sn4k3/FanController/README.md

# FanController
 PWM fan controller using ATtiny85

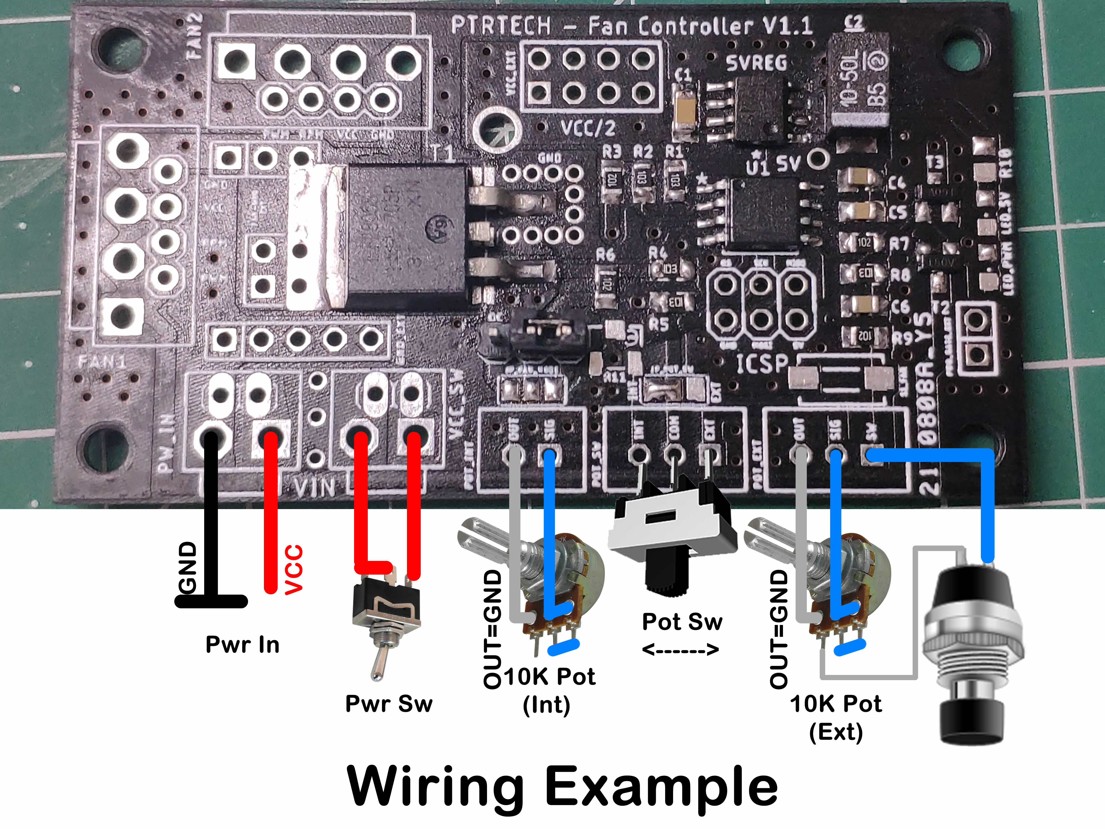
[picture p1: v1.1/img/Wiring.jpg]
Wiring example
