sn4k3/FanController/pictures/IMG_20190715_170745_1.jpg

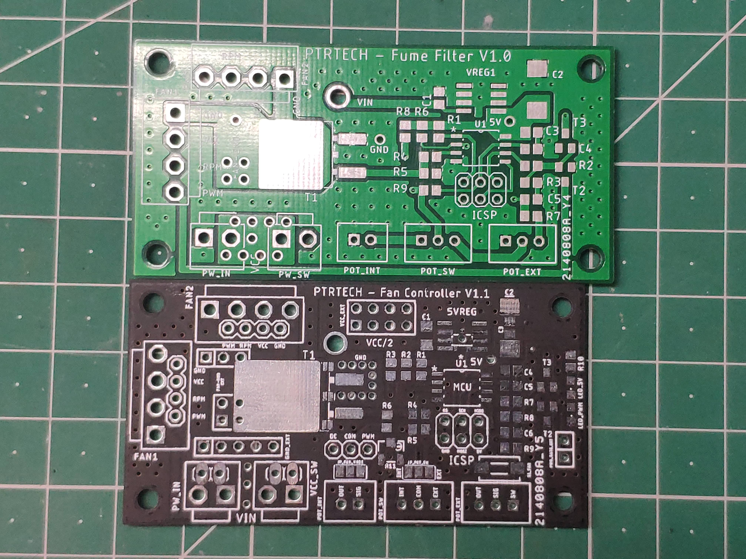
pictures/IMG_20190715_170745_1.jpg
