sn4k3/FanController/pictures/IMG_20190715_171322.jpg

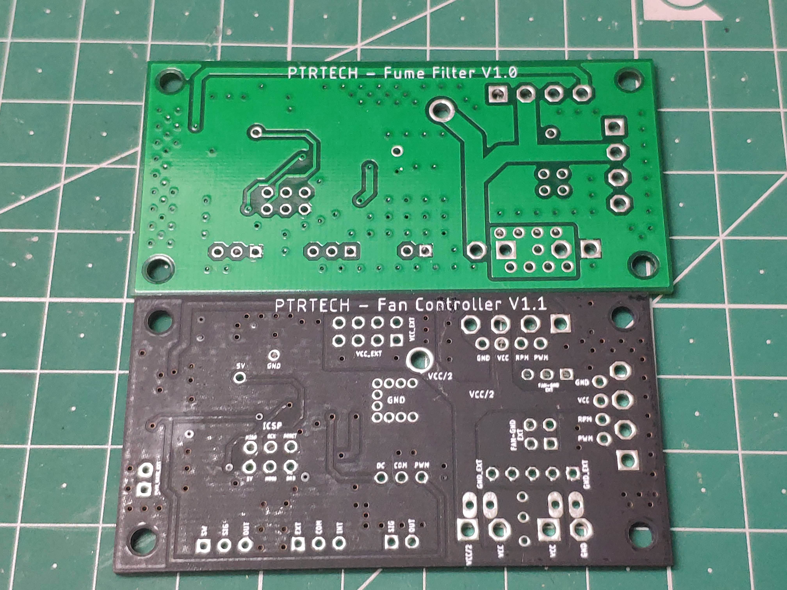
pictures/IMG_20190715_171322.jpg
