sn4k3/FanController/pictures/IMG_20190715_215148.jpg

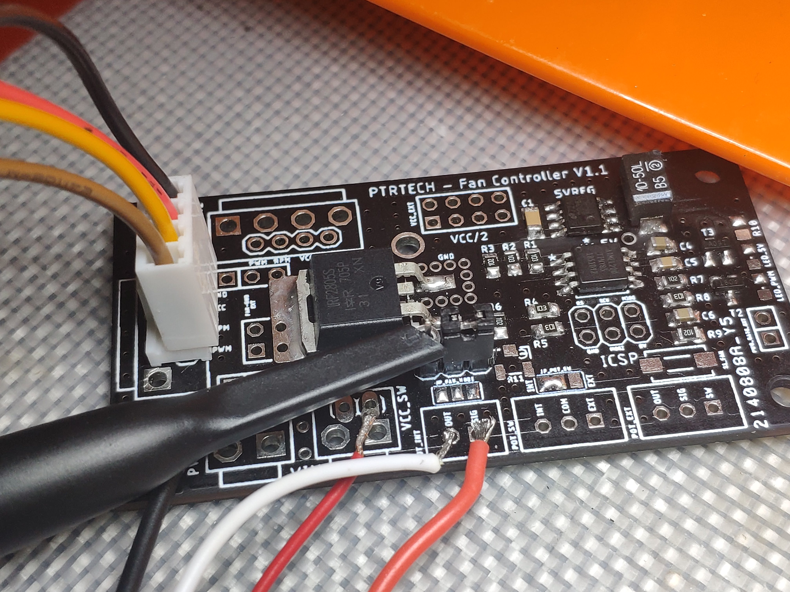
pictures/IMG_20190715_215148.jpg
