sn4k3/FanController/pictures/IMG_20190720_185601.jpg

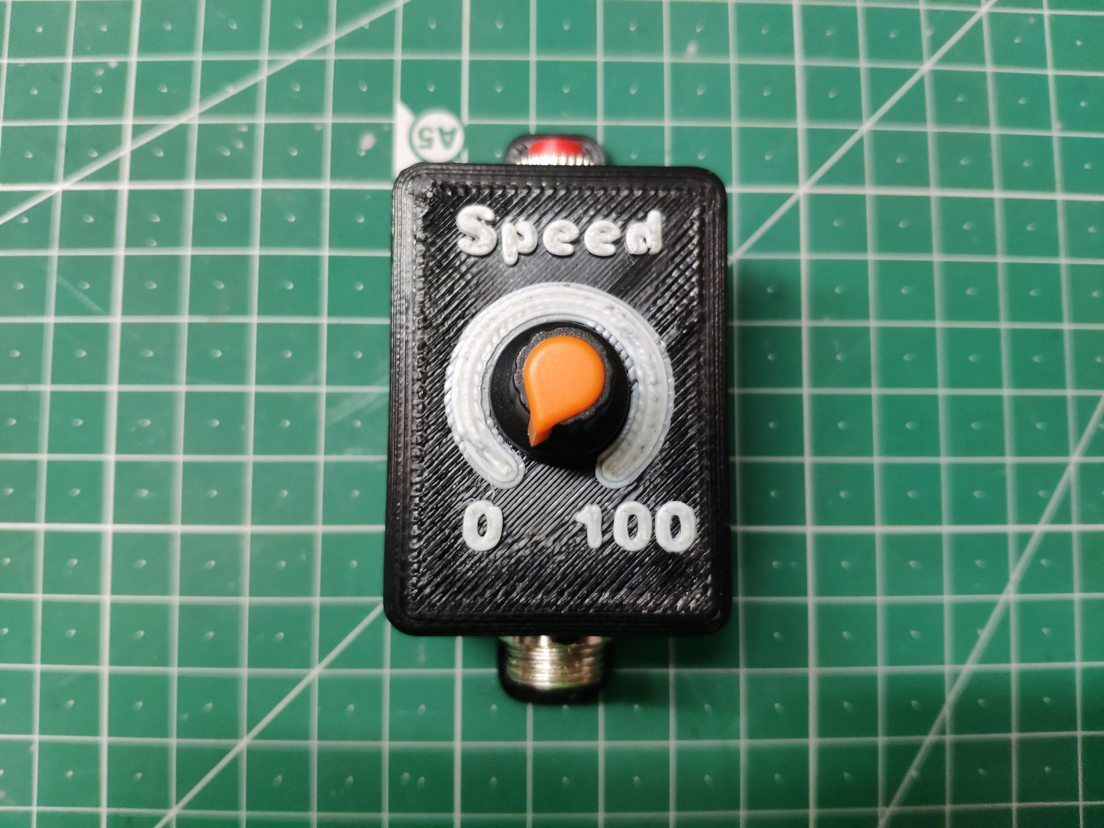
pictures/IMG_20190720_185601.jpg
