sn4k3/FanController/prototype/external_fan_controller.png

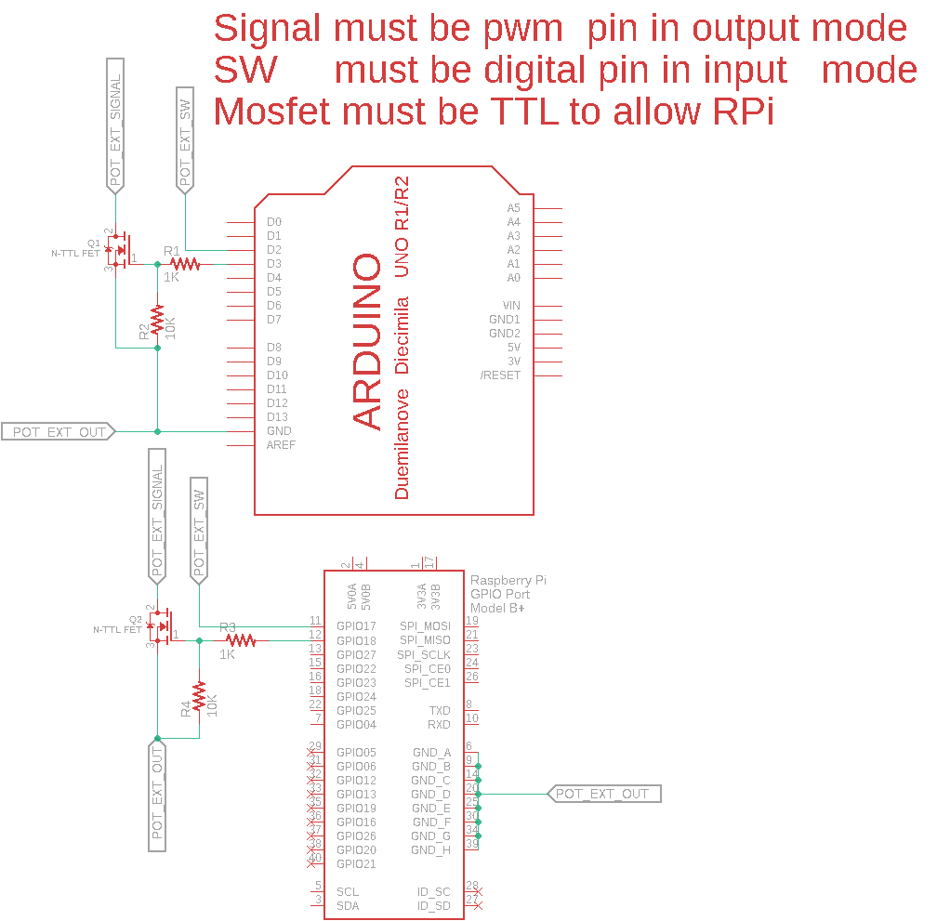
prototype/external_fan_controller.png
