sn4k3/FanController/v1.1/img/board_bottom.png

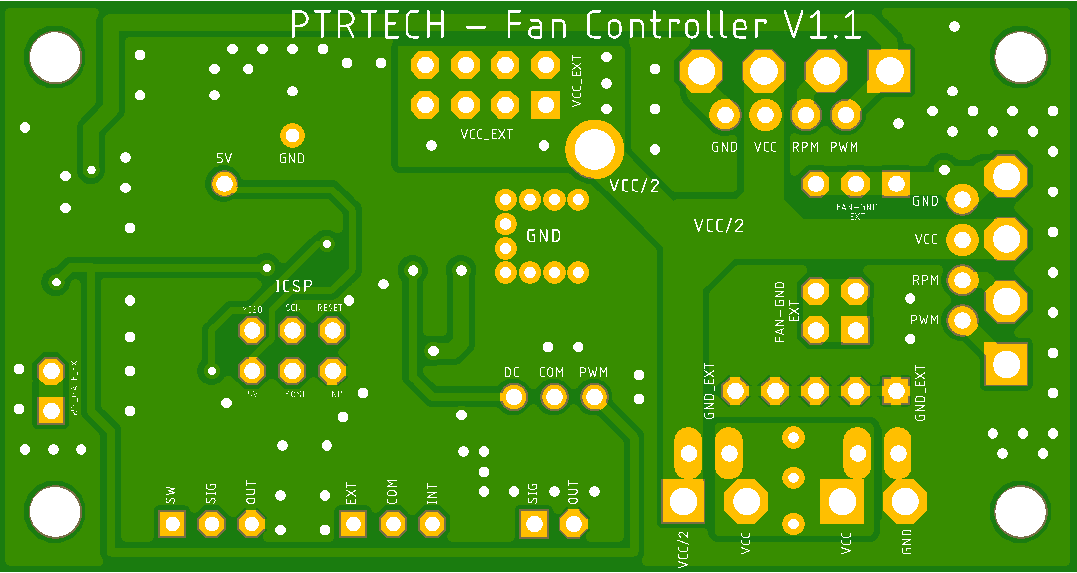
v1.1/img/board_bottom.png
