sn4k3/FanController/v1.1/img/board_top.png

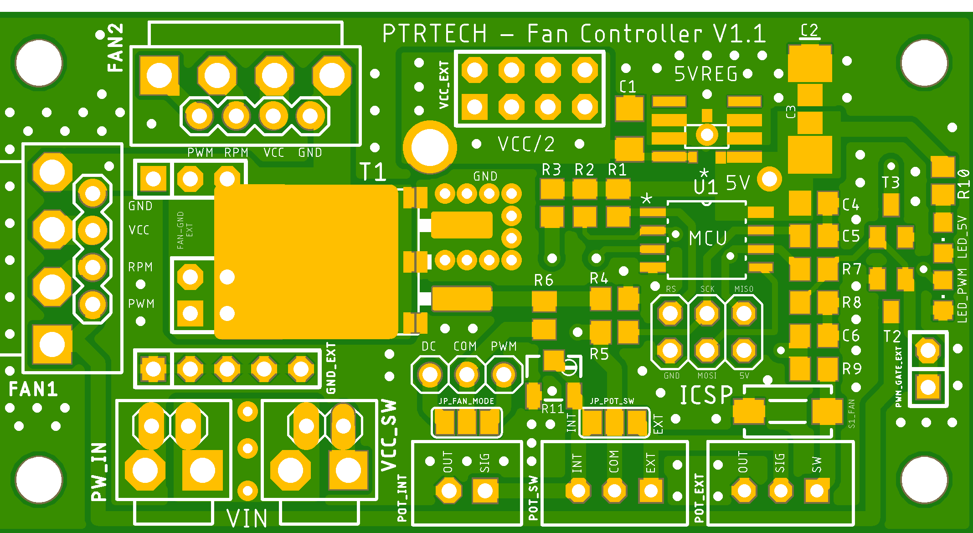
v1.1/img/board_top.png
