sn4k3/FanController/v1.1/img/schemantic.png

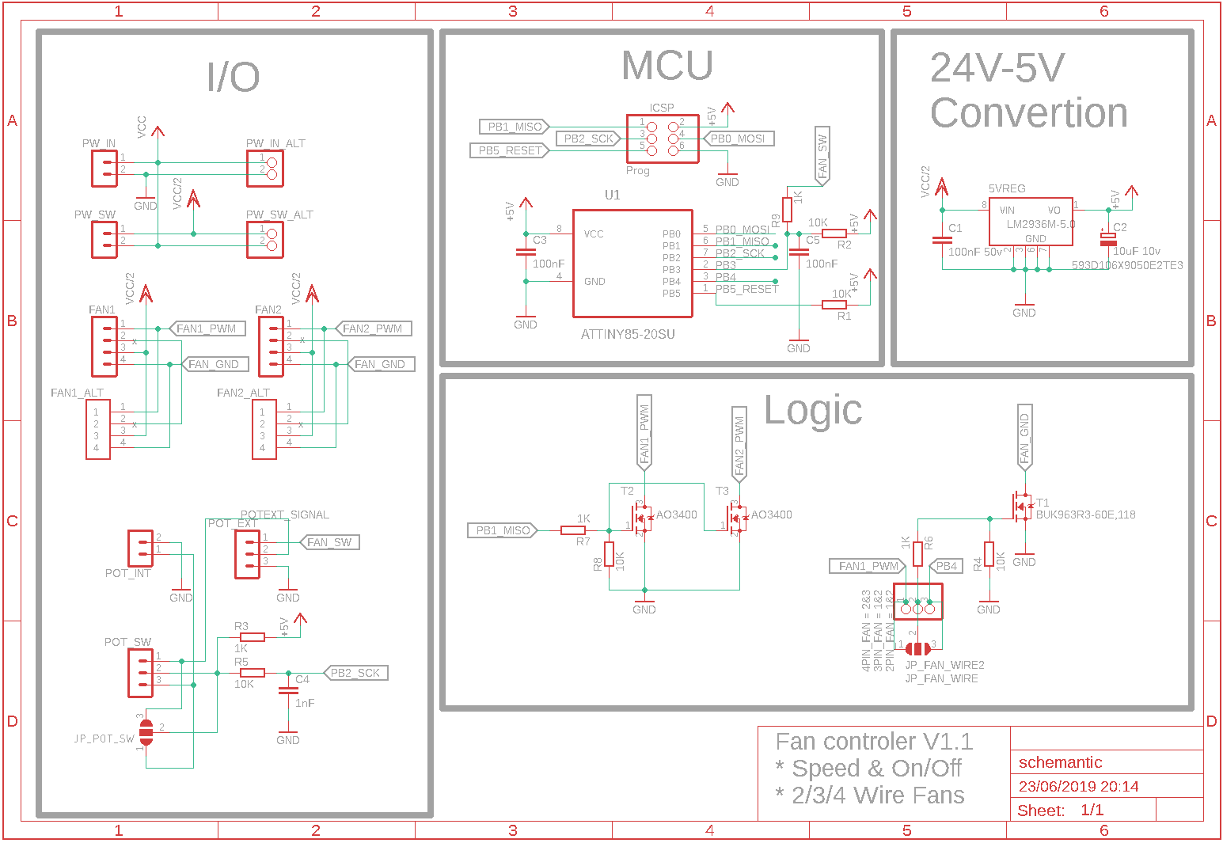
v1.1/img/schemantic.png
