sn4k3/FanController/v1.1/v1.1-stencil.stl

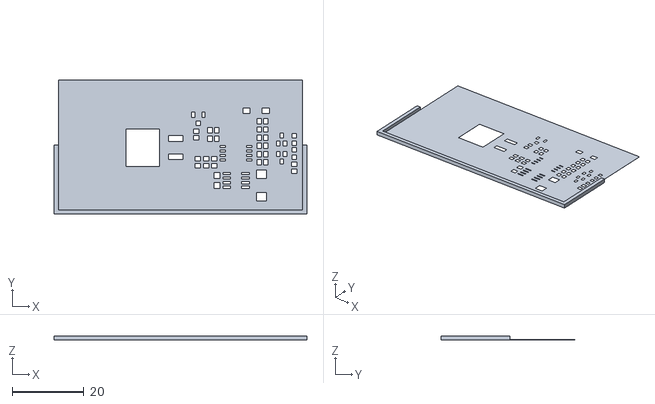
[picture p17: CAD file, 2023-09-18]
v1.1/v1.1-stencil.stl
70.7 x 37.5 x 1.20
