sn4k3/FanController/firmware/build/arduino_programmer.png

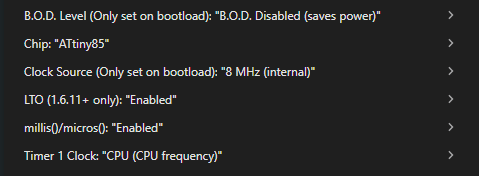
firmware/build/arduino_programmer.png
