sn4k3/FanController/firmware/build/Xgpro_Fuses.png

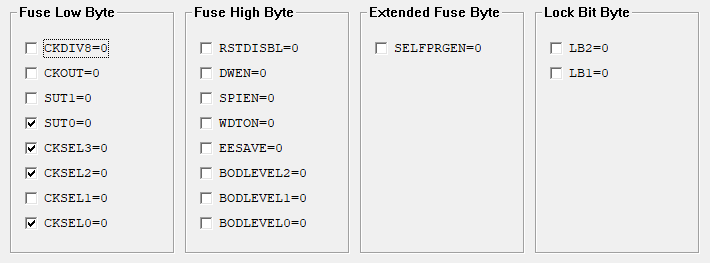
firmware/build/Xgpro_Fuses.png
