sn4k3/FanController/prototype/external_fan_controller.pdf

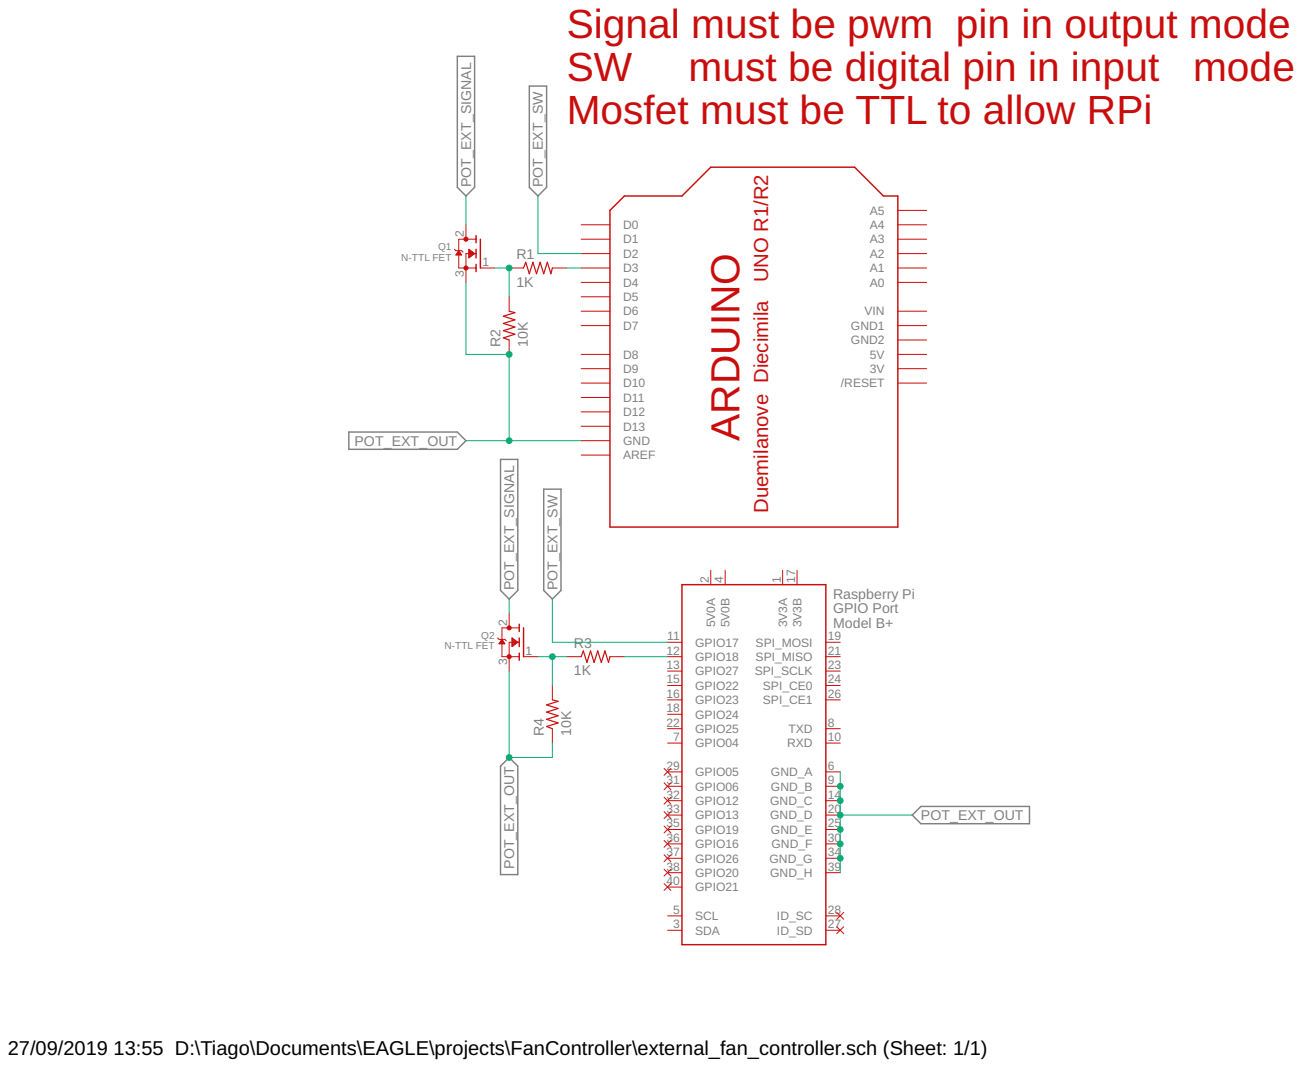
[picture p20: page 1]

Signal must be pwm pin in output mode
Mosfet must be TTL to allow RPi

27/09/2019 13:55 D:\Tiago\Documents\EAGLE\projects\FanController\external_fan_controller.sch (Sheet: 1/1)
