sn4k3/FanController/v1.1/schemantic/schemantic.kicad_pcb

## KiCad design v1.1/schemantic/schemantic.kicad_pcb (2025-07-31)

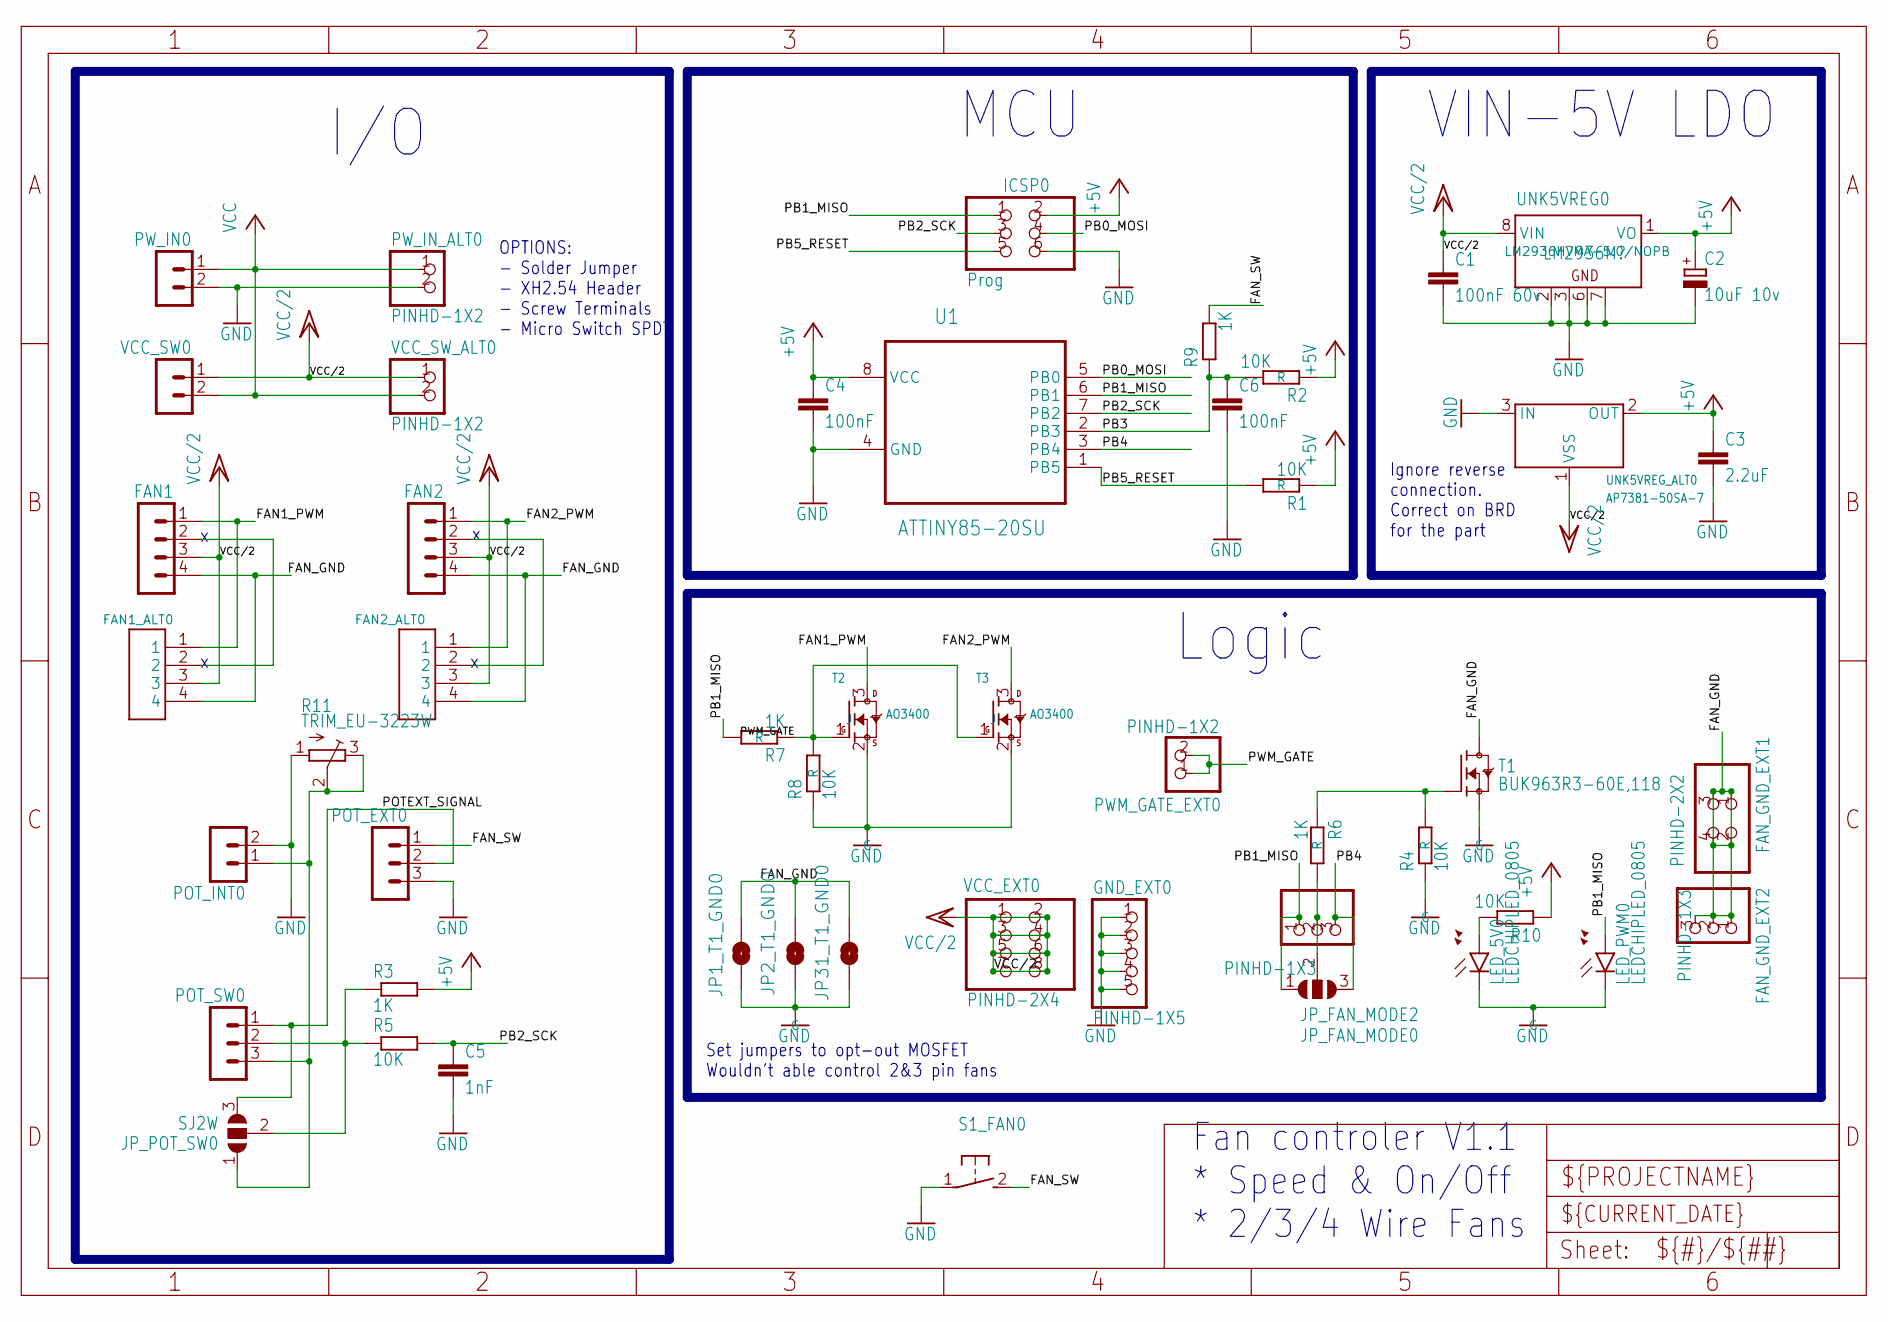
[picture p21: schematic schemantic.kicad_sch]

Parts:
C1: 100nF 60v; C1206
C2: 10uF 10v; SMC_E
C3: 2.2uF; C0805
C4, C6: 100nF; C0805
C5: 1nF; C0805
FAN1, FAN2: FAN1; B4P-VH
FAN1_ALT0, FAN2_ALT0: 1X4-BIG; 1X04-BIG
FAN_GND_EXT1: PINHD-2X2; 2X02
FAN_GND_EXT2: PINHD-1X3; 1X03
GND_EXT0: PINHD-1X5; 1X05
ICSP0: Prog; 2X03
JP1_T1_GND0, JP2_T1_GND0, JP31_T1_GND0: JUMPER-SMT_2_NO_NO-SILK; SMT-JUMPER_2_NO_NO-SILK
JP_FAN_MODE0: DC_COM_PWM; SJ_2
JP_FAN_MODE2: PINHD-1X3; 1X03
JP_POT_SW0: SJ2W; SJ_2
LED_5V0: LEDCHIPLED_0805; CHIPLED_0805
LED_PWM0: LEDCHIPLED_0805; CHIPLED_0805
POT_EXT0: POT_EXT; B3B-XH-A
POT_INT0: POT_INT; B2B-XH-A
POT_SW0: POT_SW; B3B-XH-A
PWM_GATE_EXT0: PINHD-1X2; 1X02
PW_IN0: Power In; B2P-VH
PW_IN_ALT0: PINHD-1X2; 1X02
R1, R2, R4, R5, R8, R10: 10K; R0805
R3, R6, R7, R9: 1K; R0805
R11: TRIM_EU-3223W; 3223W
S1_FAN0: DTSM-3
T1: BUK963R3-60E,118; D2PAK_TO263
T2, T3: AO3400; SOT23
U1: ATTINY85-20SU; SOIC127P798X216-8N
UNK5VREG0: LM2936M?; SO08; MPN LM2936HVMA-5.0/NOPB
UNK5VREG_ALT0: AP7381-50SA-7; XC6206_SOT-23
VCC_EXT0: PINHD-2X4; 2X04
VCC_SW0: Power SW; B2P-VH
VCC_SW_ALT0: PINHD-1X2; 1X02

Connections:
+5V: C2.+, C3.1, C4.1, ICSP0.2, R1.1, R2.1, R3.2, R10.1, U1.8 (VCC), UNK5VREG0.1 (VO), UNK5VREG_ALT0.2 (OUT)
FAN1_LATCH: FAN1.2, FAN1_ALT0.2
FAN1_PWM: FAN1.1, FAN1_ALT0.1, T2.3 (D)
FAN2_LATCH: FAN2.2, FAN2_ALT0.2
FAN2_PWM: FAN2.1, FAN2_ALT0.1, T3.3 (D)
FAN_GND: FAN1.4, FAN1_ALT0.4, FAN2.4, FAN2_ALT0.4, FAN_GND_EXT1.1, FAN_GND_EXT1.2, FAN_GND_EXT1.3, FAN_GND_EXT1.4, FAN_GND_EXT2.1, FAN_GND_EXT2.2, FAN_GND_EXT2.3, JP1_T1_GND0.2, JP2_T1_GND0.2, JP31_T1_GND0.2, T1.2 (D)
FAN_SW: POT_EXT0.1, R9.2, S1_FAN0.2
GND: C1.2, C2.-, C3.2, C4.2, C5.2, C6.2, GND_EXT0.1, GND_EXT0.2, GND_EXT0.3, GND_EXT0.4, GND_EXT0.5, ICSP0.6, JP1_T1_GND0.1, JP2_T1_GND0.1, JP31_T1_GND0.1, LED_5V0.C, LED_PWM0.C, POT_EXT0.3, POT_INT0.2, PW_IN0.2, PW_IN_ALT0.2, R4.1, R8.1, R11.1 (A), S1_FAN0.1, T1.3 (S), T2.2 (S), T3.2 (S), U1.4 (GND), UNK5VREG0.2 (GND@1), UNK5VREG0.3 (GND@2), UNK5VREG0.6 (GND@3), UNK5VREG0.7 (GND@4), UNK5VREG_ALT0.3 (IN)
JP1_COM: JP_FAN_MODE0.2, JP_FAN_MODE2.2, R6.2
LED1_ANODE: LED_5V0.A, R10.2
PB0_MOSI: ICSP0.4, U1.5 (PB0)
PB1_MISO: ICSP0.1, JP_FAN_MODE0.1, JP_FAN_MODE2.1, LED_PWM0.A, R7.2, U1.6 (PB1)
PB2_SCK: C5.1, ICSP0.3, R5.2, U1.7 (PB2)
PB3: C6.1, R2.2, R9.1, U1.2 (PB3)
PB4: JP_FAN_MODE0.3, JP_FAN_MODE2.3, U1.3 (PB4)
PB5_RESET: ICSP0.5, R1.2, U1.1 (PB5)
POTEXT_SIGNAL: JP_POT_SW0.3, POT_EXT0.2, POT_SW0.1
POTINT_SIGNAL: JP_POT_SW0.1, POT_INT0.1, POT_SW0.3, R11.2 (S), R11.3 (E)
POTSW_COM: JP_POT_SW0.2, POT_SW0.2, R3.1, R5.1
PWM_GATE: PWM_GATE_EXT0.1, PWM_GATE_EXT0.2, R7.1, R8.2, T2.1 (G), T3.1 (G)
T1_GATE: R4.2, R6.1, T1.1 (G)
VCC: PW_IN0.1, PW_IN_ALT0.1, VCC_SW0.2, VCC_SW_ALT0.2
VCC/2: C1.1, FAN1.3, FAN1_ALT0.3, FAN2.3, FAN2_ALT0.3, UNK5VREG0.8 (VIN), UNK5VREG_ALT0.1 (VSS), VCC_EXT0.1, VCC_EXT0.2, VCC_EXT0.3, VCC_EXT0.4, VCC_EXT0.5, VCC_EXT0.6, VCC_EXT0.7, VCC_EXT0.8, VCC_SW0.1, VCC_SW_ALT0.1

Notes on the sheet:
I/O
Fan controler V1.1 * Speed & On/Off * 2/3/4 Wire Fans
Logic
Set jumpers to opt-out MOSFET Wouldn't able control 2&3 pin fans
Ignore reverse connection. Correct on BRD for the part
OPTIONS: - Solder Jumper - XH2.54 Header - Screw Terminals - Micro Switch SPDT
MCU
VIN-5V LDO

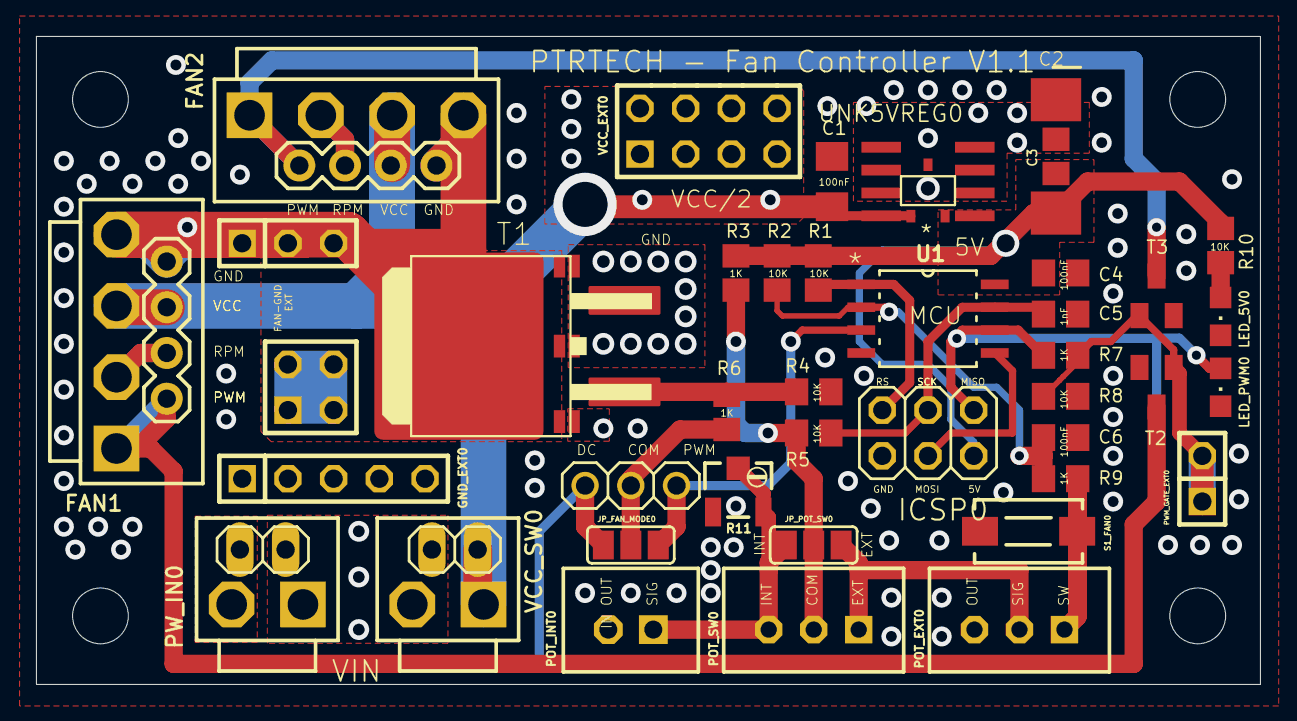
[picture p22: board schemantic.kicad_pcb from above]

Board: 2 copper layers, 68.0 x 36.0 mm, 53 parts (0 on the bottom side), 23 nets.

Other parts of the board:
UNK_HOLE_0: dummyfp0
UNK_HOLE_1: dummyfp1
UNK_HOLE_2: dummyfp2
UNK_HOLE_3: dummyfp3
