sn4k3/FanController/v1.0/schemantic.brd

## EAGLE design v1.0/schemantic.brd (2023-09-18, an earlier design)

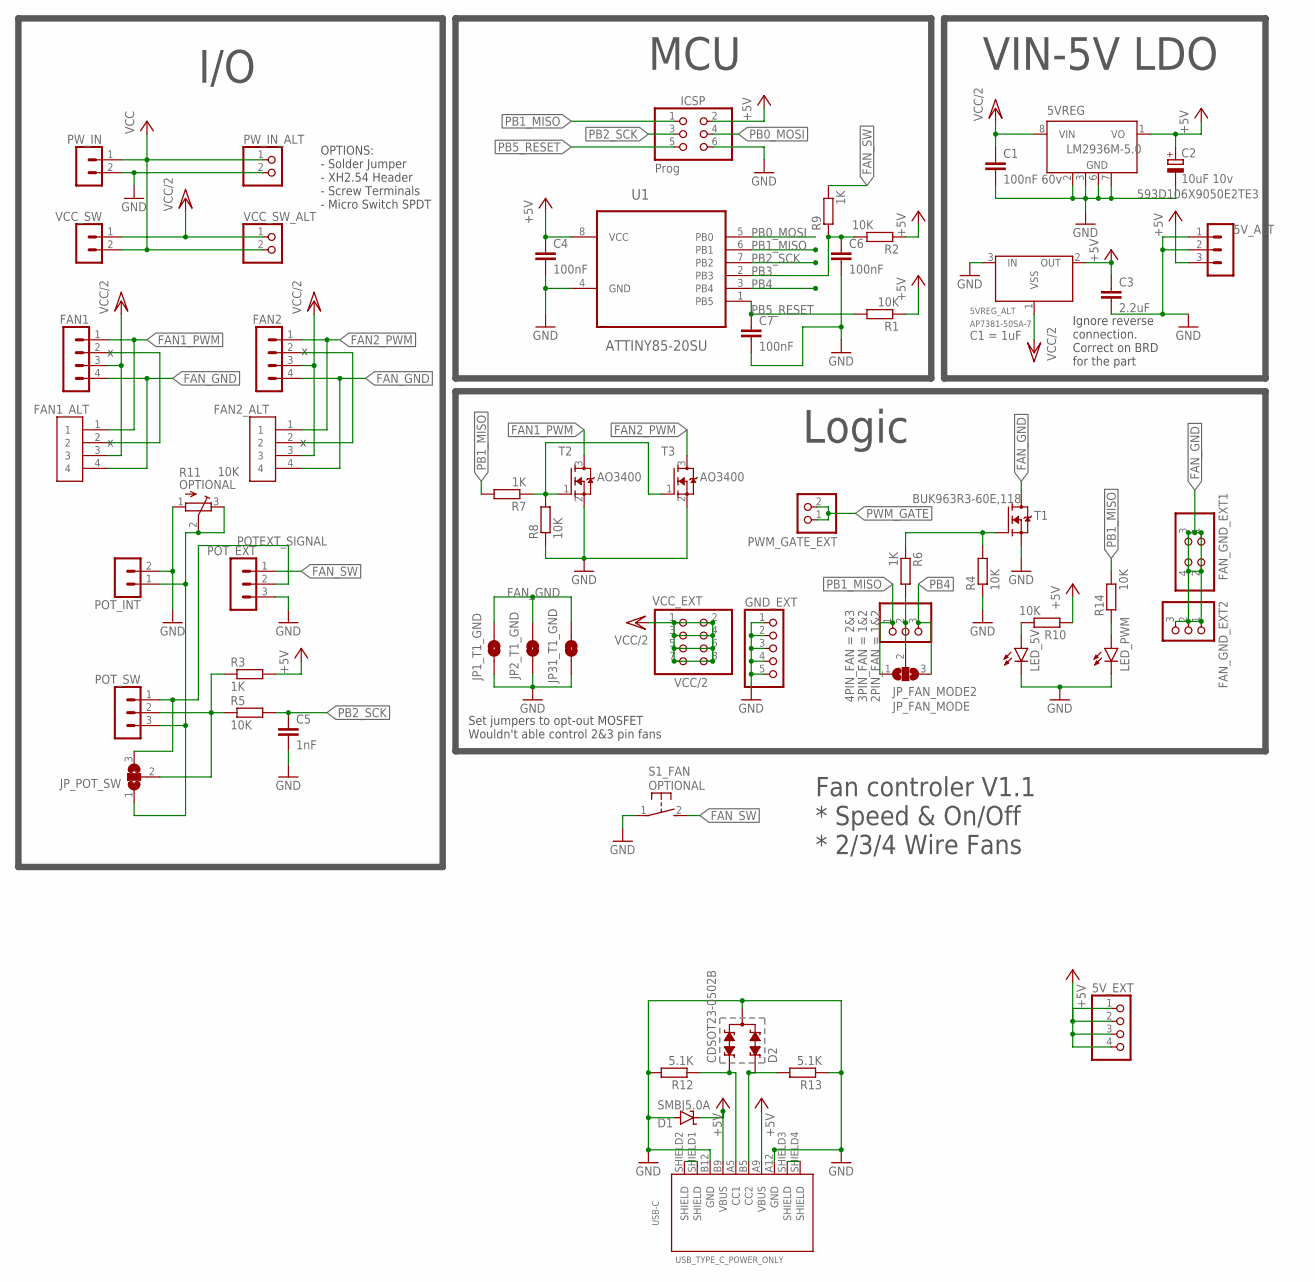
[picture p23: schematic schemantic.sch]

Parts:
5VREG: LM2936M-5.0; SO08; MPN LM2936HVMA-5.0/NOPB
5VREG_ALT: AP7381-50SA-7; XC6206_SOT-23
5V_ALT: B3B-XH-2; B3B-XH-A
5V_EXT: PINHD-1X4; 1X04
C1: 100nF 60v; C1206
C2: 10uF 10v; SMC_E
C3: 2.2uF; C0603
C4, C6, C7: 100nF; C0603
C5: 1nF; C0603
D1: SMBJ5.0A; SMBJ
D2: CDSOT23-0502B; SOT23
FAN1, FAN2: FAN1; B4P-VH
FAN1_ALT, FAN2_ALT: 1X4-BIG; 1X04-BIG
FAN_GND_EXT1: PINHD-2X2; 2X02
FAN_GND_EXT2: PINHD-1X3; 1X03
GND_EXT: PINHD-1X5; 1X05
ICSP: Prog; 2X03
JP1_T1_GND, JP2_T1_GND, JP31_T1_GND: JUMPER-SMT_2_NO_NO-SILK; SMT-JUMPER_2_NO_NO-SILK
JP_FAN_MODE: DC_COM_PWM; SJ_2
JP_FAN_MODE2: PINHD-1X3; 1X03
JP_POT_SW: SJ2W; SJ_2
LED_5V: LEDCHIPLED_0805; CHIPLED_0805
LED_PWM: LEDCHIPLED_0805; CHIPLED_0805
POT_EXT: POT_EXT; B3B-XH-A
POT_INT: POT_INT; B2B-XH-A
POT_SW: POT_SW; B3B-XH-A
PWM_GATE_EXT: PINHD-1X2; 1X02
PW_IN: Power In; B2P-VH
PW_IN_ALT: PINHD-1X2; 1X02
R1, R2, R4, R5, R8, R10, R14: 10K; R0603
R3, R6, R7, R9: 1K; R0603
R11: 10K; 3223W
R12, R13: 5.1K; R0603
S1_FAN: DTSM-3
T1: BUK963R3-60E,118; D2PAK_TO263
T2, T3: AO3400; SOT23
U1: ATTINY85-20SU; SOIC127P798X216-8N
USB-C: USB_TYPE_C_POWER_ONLY
VCC_EXT: PINHD-2X4; 2X04
VCC_SW: Power SW; B2P-VH
VCC_SW_ALT: PINHD-1X2; 1X02

Connections:
+5V: 5VREG.1 (VO), 5VREG_ALT.2 (OUT), 5V_ALT.3, 5V_EXT.1, 5V_EXT.2, 5V_EXT.3, 5V_EXT.4, C2.+, C3.1, C4.1, D1.C, ICSP.2, R1.1, R2.1, R3.2, R10.1, U1.8 (VCC), USB-C.A9 (VBUS), USB-C.B9 (VBUS)
FAN1_LATCH: FAN1.2, FAN1_ALT.2
FAN1_PWM: FAN1.1, FAN1_ALT.1, T2.3 (D)
FAN2_LATCH: FAN2.2, FAN2_ALT.2
FAN2_PWM: FAN2.1, FAN2_ALT.1, T3.3 (D)
FAN_GND: FAN1.4, FAN1_ALT.4, FAN2.4, FAN2_ALT.4, FAN_GND_EXT1.1, FAN_GND_EXT1.2, FAN_GND_EXT1.3, FAN_GND_EXT1.4, FAN_GND_EXT2.1, FAN_GND_EXT2.2, FAN_GND_EXT2.3, JP1_T1_GND.2, JP2_T1_GND.2, JP31_T1_GND.2, T1.2 (D)
FAN_SW: POT_EXT.1, R9.2, S1_FAN.2
GND: 5VREG.2 (GND), 5VREG.3 (GND), 5VREG.6 (GND), 5VREG.7 (GND), 5VREG_ALT.3 (IN), 5V_ALT.1, 5V_ALT.2, C1.2, C2.-, C3.2, C4.2, C5.2, C6.2, C7.2, D1.A, D2.3, GND_EXT.1, GND_EXT.2, GND_EXT.3, GND_EXT.4, GND_EXT.5, ICSP.6, JP1_T1_GND.1, JP2_T1_GND.1, JP31_T1_GND.1, LED_5V.C, LED_PWM.C, POT_EXT.3, POT_INT.2, PW_IN.2, PW_IN_ALT.2, R4.1, R8.1, R11.1 (A), R12.2, R13.1, S1_FAN.1, T1.3 (S), T2.2 (S), T3.2 (S), U1.4 (GND), USB-C.A12 (GND), USB-C.B12 (GND)
JP1_COM: JP_FAN_MODE.2, JP_FAN_MODE2.2, R6.2
LED1_ANODE: LED_5V.A, R10.2
LED2_ANODE: LED_PWM.A, R14.1
unnamed: USB-C.SHIELD1 (SHIELD), USB-C.SHIELD2 (SHIELD)
unnamed: USB-C.SHIELD3 (SHIELD), USB-C.SHIELD4 (SHIELD)
PB0_MOSI: ICSP.4, U1.5 (PB0)
PB1_MISO: ICSP.1, JP_FAN_MODE.1, JP_FAN_MODE2.1, R7.2, R14.2, U1.6 (PB1)
PB2_SCK: C5.1, ICSP.3, R5.2, U1.7 (PB2)
PB3: C6.1, R2.2, R9.1, U1.2 (PB3)
PB4: JP_FAN_MODE.3, JP_FAN_MODE2.3, U1.3 (PB4)
PB5_RESET: C7.1, ICSP.5, R1.2, U1.1 (PB5)
POTEXT_SIGNAL: JP_POT_SW.3, POT_EXT.2, POT_SW.1
POTINT_SIGNAL: JP_POT_SW.1, POT_INT.1, POT_SW.3, R11.2 (S), R11.3 (E)
POTSW_COM: JP_POT_SW.2, POT_SW.2, R3.1, R5.1
PWM_GATE: PWM_GATE_EXT.1, PWM_GATE_EXT.2, R7.1, R8.2, T2.1 (G), T3.1 (G)
T1_GATE: R4.2, R6.1, T1.1 (G)
USBC_CC1: D2.2, R12.1, USB-C.A5 (CC1)
USBC_CC2: D2.1, R13.2, USB-C.B5 (CC2)
VCC: PW_IN.1, PW_IN_ALT.1, VCC_SW.2, VCC_SW_ALT.2
VCC/2: 5VREG.8 (VIN), 5VREG_ALT.1 (VSS), C1.1, FAN1.3, FAN1_ALT.3, FAN2.3, FAN2_ALT.3, VCC_EXT.1, VCC_EXT.2, VCC_EXT.3, VCC_EXT.4, VCC_EXT.5, VCC_EXT.6, VCC_EXT.7, VCC_EXT.8, VCC_SW.1, VCC_SW_ALT.1

Notes on the sheet:
VIN-5V LDO
I/O
MCU
Logic
Fan controler V1.1 * Speed & On/Off * 2/3/4 Wire Fans
Ignore reverse connection. Correct on BRD for the part
Set jumpers to opt-out MOSFET Wouldn't able control 2&3 pin fans
OPTIONS: - Solder Jumper - XH2.54 Header - Screw Terminals - Micro Switch SPDT

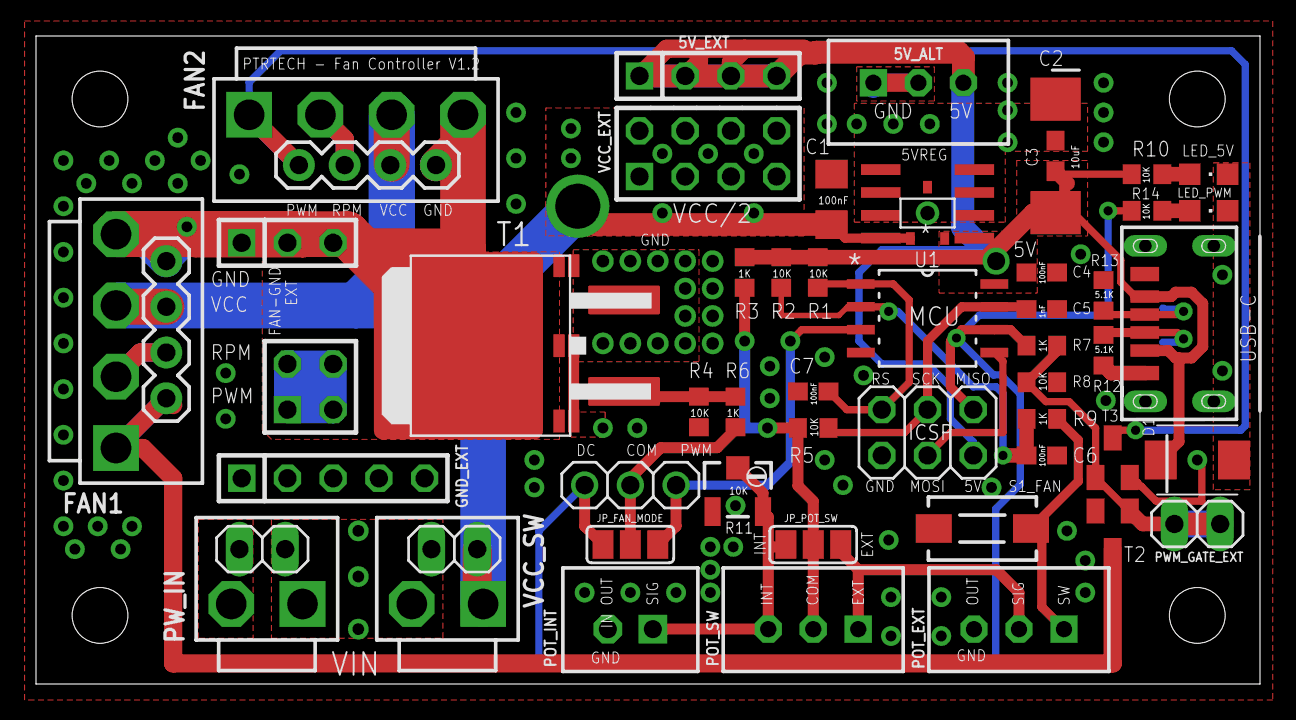
[picture p24: board schemantic.brd from above]

Board: 2 copper layers, 68.0 x 36.0 mm, 58 parts (1 on the bottom side), 28 nets.
