sn4k3/FanController/(notices)

Notices in the files:
parts and their libraries:
con-jst-vh: Copyright (C) 02/2017, kylie
SparkFun-Jumpers: Licensing: Creative Commons ShareAlike 4.0 International - https://creativecommons.org/licenses/by-sa/4.0
